MHamiid/Programmable_8-bit_Computer/README.md

# Programmable_8-bit_Computer
Simulated [Ben Eater](https://eater.net/8bit)'s programmable 8-bit computer from scratch using only simple logic gates and basic ICs

## Modules
[Clock](#clock)  
[Bus](#bus)  
[A Register](#a-register)  
[B Register](#b-register)  
[ALU](#alu)  
[Flags Register](#flags-register)  
[Memory Address Register](#memory-address-register)  
[Memory](#memory)  
[Manual Memory Input](#manual-memory-input)  
[Program Counter](#program-counter)  
[Output Display](#output-display)  
[Instruction Register](#instruction-register)  
[Control Unit](#control-unit)  
[Reset](#reset)  
[Serial Monitor](#serial-monitor)  

## Clock
Clock can operate in **two modes**:
- Astable Mode
- Monostable Mode

In __Astable Mode__ clock speed can be changed by adjusting the _potentiometer_

In __Monostable Mode__ single clock pulse can be generated by pressing the _Generate Clock Pulse Button_

### Main Components
- 2 X 555 ( Timer/Oscillator )

### Clock Selector Truth Table
| **Mode Selector Switch** | **Halt Signal** | **Clock Output**  |
|:---:|:---:|:---:|
| Low | Low | Astable Mode |
| High | Low | Monostable Mode |
| X | High | Low |

### Schematic
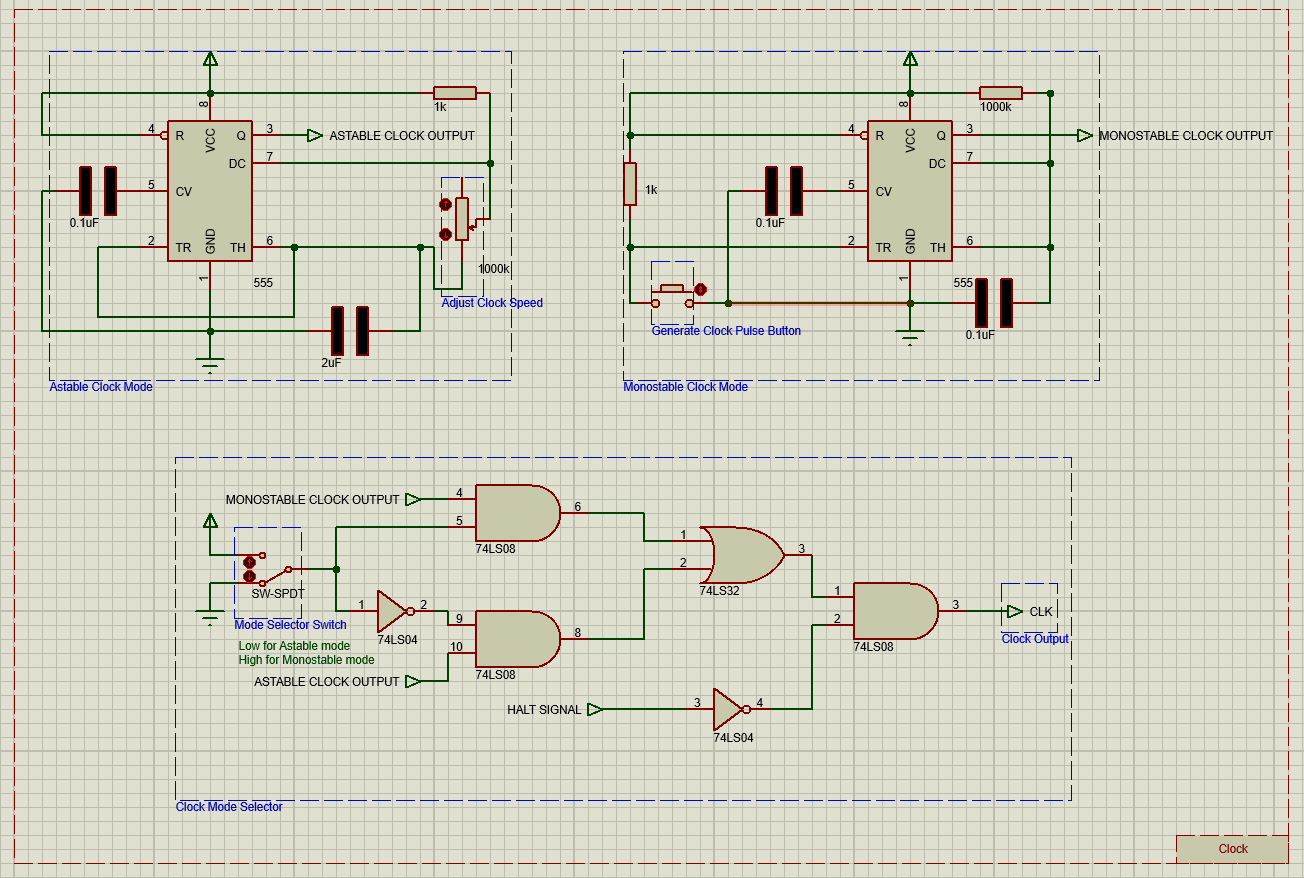
[picture p1: img/Clock_Module.png]
Clock Module


## Bus
All modules are connected to the **Bus** using a **tristate** to connect multiple outputs together

The **Bus** is connected to _pull down resistors_ to pull the **Bus** to _ground_ by default if there is no input

### Schematic
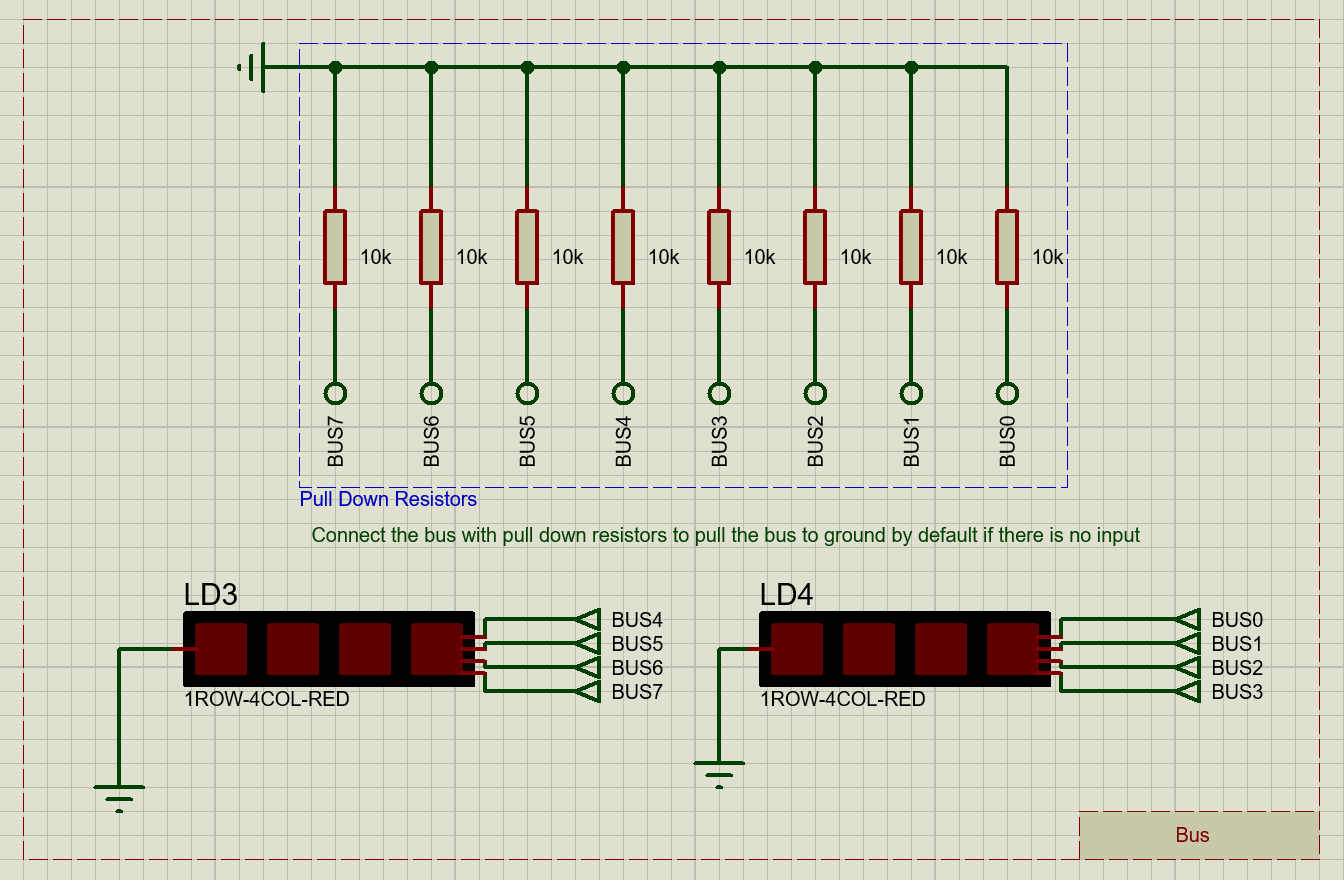
[picture p2: img/Bus_Module.png]
Bus Module


## A-Register
**A-Register** is an _8-bit_ register combined from _two 4-bit_ registers

The **register** is connected to the [Bus](#bus) through a _Tristate_

The **register** also has a direct connection to [ALU](#alu)'s inputs

### Main Components
- 2 X 74LS173 ( Quad D-Type Filp-Flops With Tristate Outputs )
- 74LS245 ( Octal Bus Transceivers With Tristate Outputs )

### A-Register Signals
| **Signal** | **Functionality** |
|:---:|:---:|
|  A Register In Signal | Read the [Bus](#bus) content into **A Register** |
| A Register Out Signal | Output **A Register** content to the [Bus](#bus) |
| Active High Reset | Reset **A Register** content |

### Schematic
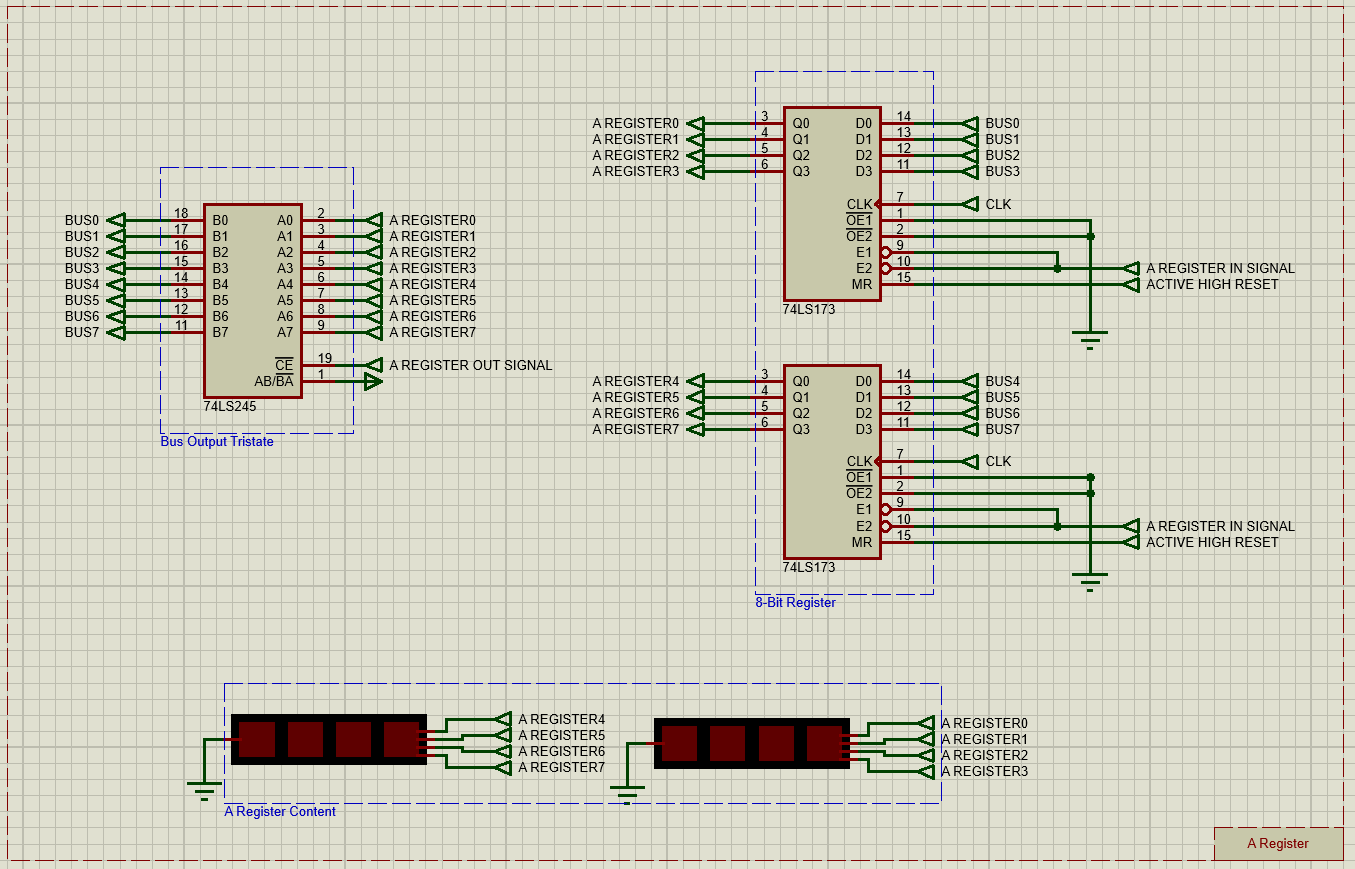
[picture p3: img/A-Register_Module.png]
A-Register Module


## B-Register
**B-Register** is an _8-bit_ register combined from _two 4-bit_ registers

The **register** is connected to the [Bus](#bus) through a _Tristate_

The **register** also has a connection to [ALU](#alu)'s inputs through _XOR Gates_ that decide whether the **register**'s content should be negated or not based on the **Subtraction Signal** for _subtraction_ operations

### Main Components
- 2 X 74LS173 ( Quad D-Type Filp-Flops With Tristate Outputs )
- 74LS245 ( Octal Bus Transceivers With Tristate Outputs )
- 8 X 74LS86 ( 2-Input Exclusive-OR Gate )

### B-Register Signals
| **Signal** | **Functionality** |
|:---:|:---:|
|  B Register In Signal | Read the [Bus](#bus) content into **B Register** |
| B Register Out Signal | Output **B Register** content to the [Bus](#bus) |
| Subtract Signal | Negate **B Register** content ( Get one's complement ) |
| Active High Reset | Reset **B Register** content |

**Note:** The [Control Unit](#control-unit) currently has no **Microinstruction** that controls the **B Register Out Signal**, and the signal is manually fixed to be _inactive (aka HIGH)_ 

### Schematic
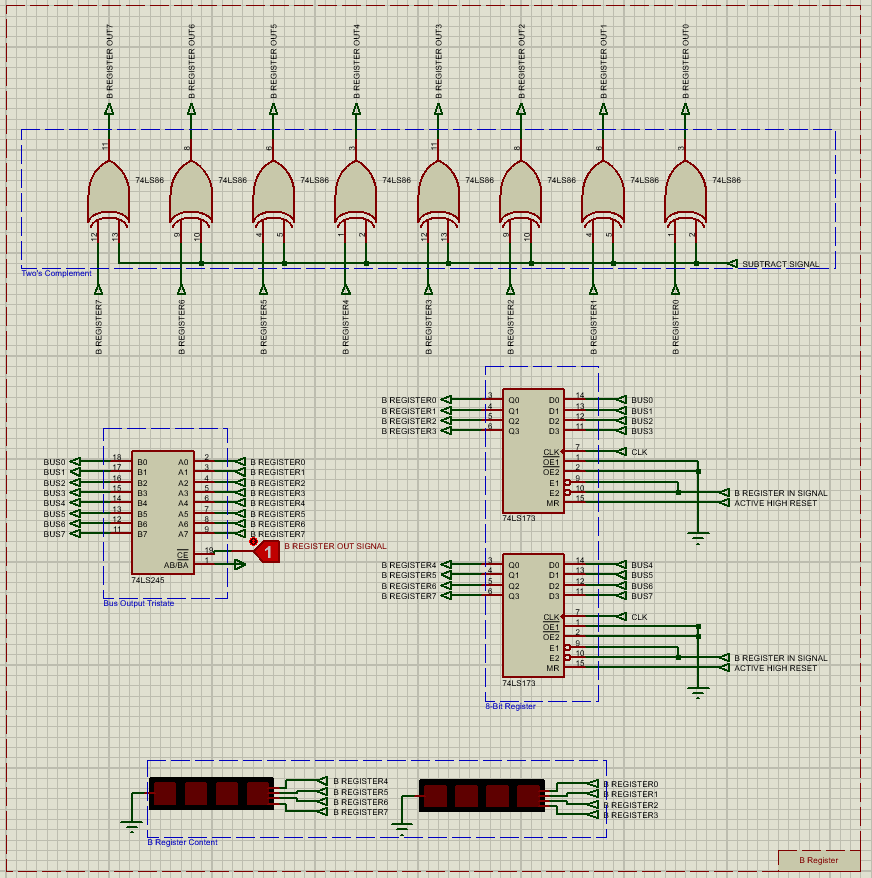
[picture p4: img/B-Register_Module.png]
B-Register Module


## ALU
**ALU** is an _8-bit_ **Full Adder** combined from _two 4-bit_ **Full Adders**

Both [A-Register](#a-register) and [B-Register](#b-register) are connected to the **ALU**'s input, and the **ALU** is _constantly_ operating on them

**ALU** supports two **Arithmetic Operations**:
- Addition
- Subtraction

**Subtraction** is achieved when the **Subtraction Signal** is enabled _(Active **HIGH**)_, resulting in the [B-Register](#b-register)'s content to be negated, hence, getting **One's Complement**. And the **Subtraction Signal** is also fed to the **carry In** of the first **Full Adder** of the **ALU** **_(C0)_** _(Note the **Subtraction Signal** is active **HIGH**)_, hence, getting **Two's Complement**

**ALU** generates two **Flags**:
- Carry Flag
- Zero Flag

### Main Components
- 2 X 74LS283 ( 4-Bit Binary Full Adders With Fast Carry )
- 74LS245 ( Octal Bus Transceivers With Tristate Outputs )
- 74HC4078 ( 8-Input NOR Gate )

### ALU Signals
| **Signal** | **Functionality** |
|:---:|:---:|
|  ALU Out Signal | Output **ALU** content to the [Bus](#bus) |
| Subtract Signal | Fed to the **Carry In** for subtraction operation ( Get two's complement ) |

### Schematic
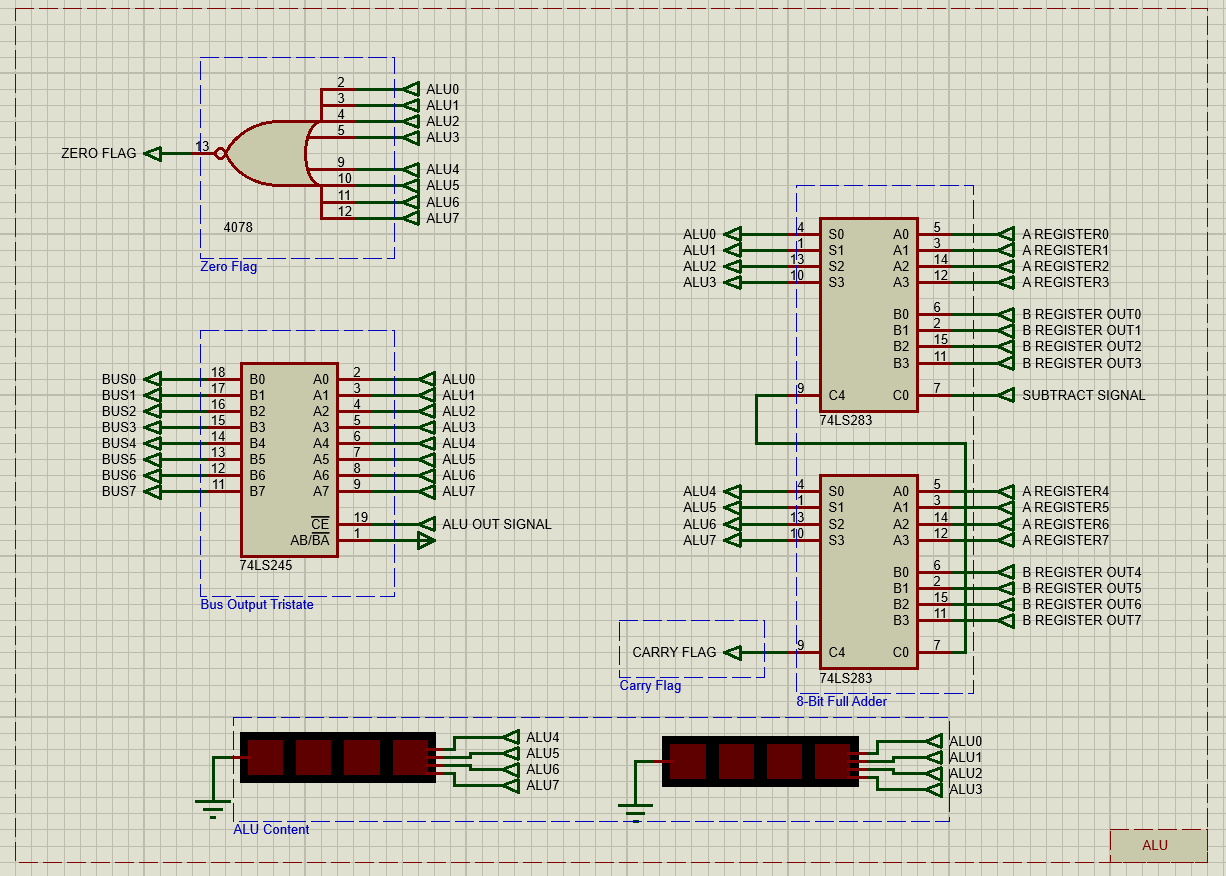
[picture p5: img/ALU_Module.png]
ALU Module


## Flags-Register
**Flags Register** is a 4-bit register, which stores the [ALU](#alu)'s two generated flags:
- Carry Flag
- Zero Flag

when the **Flags Register In Signal** is enabled

The **register**'s output flags are connected to the [Control Unit](#control-unit) to support the **Jump Carry and Jump Zero Instructions** 

### Main Components
- 74LS173 ( Quad D-Type Filp-Flops With Tristate Outputs )

### Flags-Register Signals
| **Signal** | **Functionality** |
|:---:|:---:|
| Flags Register In Signal | Read [ALU](#alu)'s **Flags** into **Flags Register** |
| Active High Reset | Reset **Flags Register** content |

### Schematic
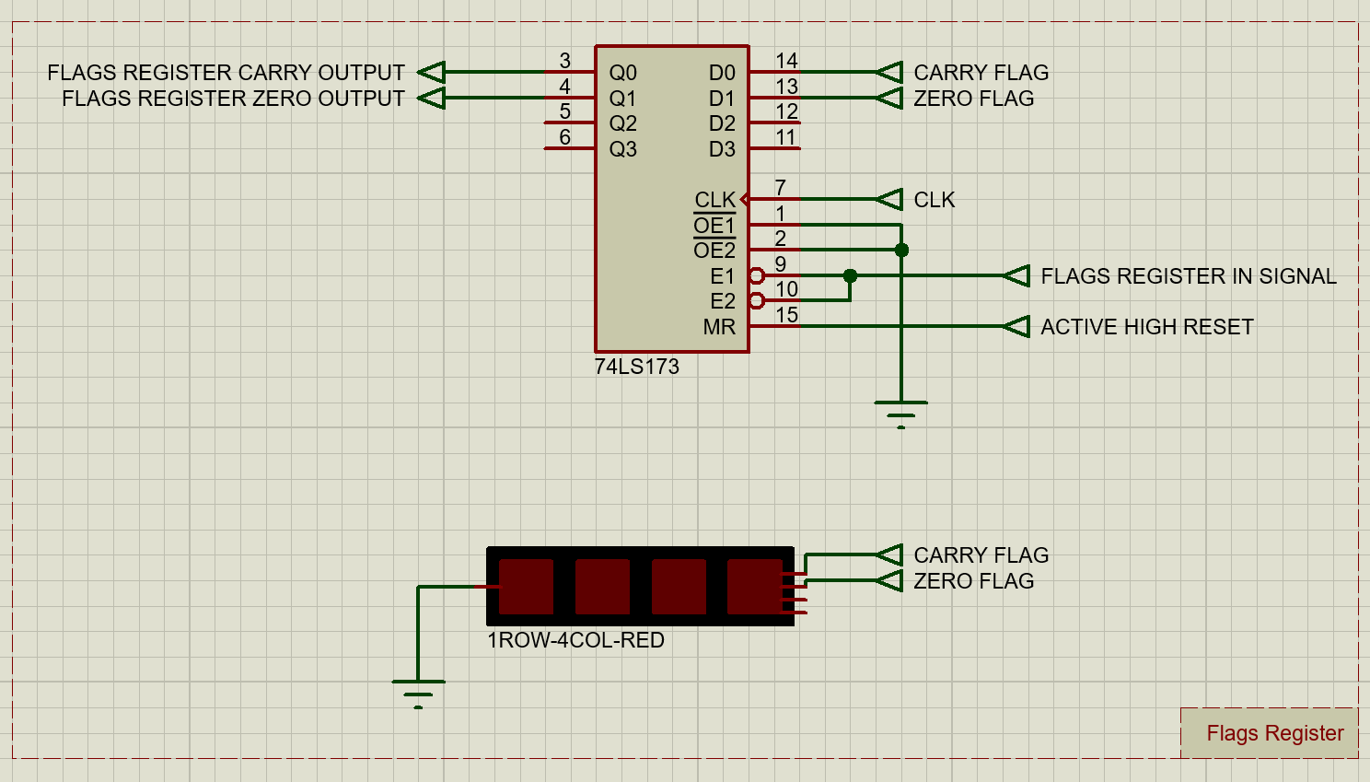
[picture p6: img/Flags-Register_Module.png]
Flags Register Module


## Memory-Address-Register
**Memory Address Register** is a 4-bit register, which stores the 4-bit **memory** address where the **memory** is going to read and output this address content _(If it is **Run Mode**, otherwise in **Programming Mode**, the **memory** is going to use and output the content of the **Manual Address Input**)_

The **register**'s output is connected to the **Memory Address Input Selector** 

### Main Components
- 74LS173 ( Quad D-Type Filp-Flops With Tristate Outputs )

### Memory-Address-Register Signals
| **Signal** | **Functionality** |
|:---:|:---:|
| Memory Address In Signal | Read the [Bus](#bus) content into **Memory Address Register** |
| Active High Reset | Reset **Memory Address Register** content |

### Schematic
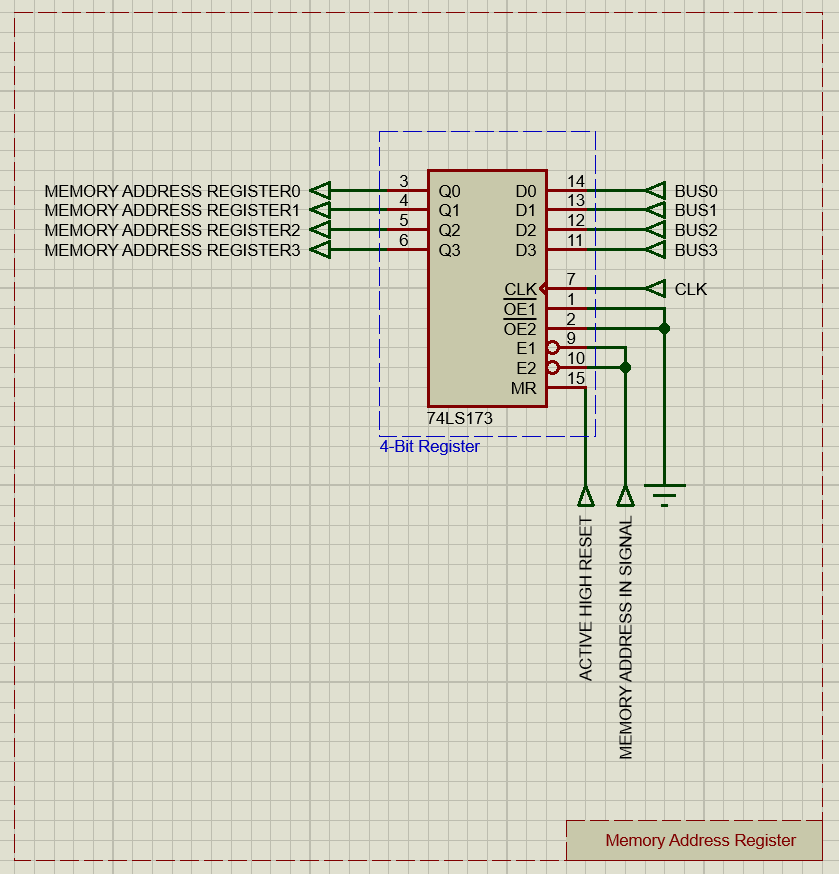
[picture p7: img/Memory-Address-Register_Module.png]
Memory Address Register Module


## Memory
**Memory** is a **128-bit (16 X 8)** memory combined from _two 64-bit (16 X 4)_ **Random Access Read/Write Memory**

The **Memory** is connected to the [Bus](#bus) through a _Tristate_

The inputs **(Memory Data Input, Memory Address, and Memory Write Enable)** to the **Memory** is the outputs of the **Memory Data Input Selector/Multiplexer, Memory Address Input Selector/Multiplexer, and Memory Write Enable Selector/Multiplexer** where the:

- **Memory Data Input Selector/Multiplexer**: Decides whether the _manual memory data input_ or _the data on the [Bus](#bus)_ will be used as an input to the **Memory**

- **Memory Address Input Selector/Multiplexer**: Decides whether the _manual memory address input_ or _the address in the [Memory Address Register](#memory-address-register)_ will be used as an input to the **Memory**

- **Memory Write Enable Selector/Multiplexer**: Decides whether the _manual memory write enable_ or _the **Memory In Signal** with the positive edge of the clock_ will be used as an input to the **Memory**

The **Manual Inputs** referenced above are generated from the [Manual Memory Input Module](#manual-memory-input)

All **Selectors/Mutliplexers** selects the input to the **Memory** based on the **Programming Mode Enable Signal** generated also in the [Manual Memory Input Module](#manual-memory-input)

### Main Components
- 2 X 74LS189 ( 64-Bit Random Access Read/Write Memory )
- 4 X 74LS157 ( Quadruple 1-of-2 Data Selectors/Multiplexers )
- 74LS245 ( Octal Bus Transceivers With Tristate Outputs )

### Memory Signals
| **Signal** | **Functionality** |
|:---:|:---:|
| Memory Out Signal | Output **Memory** content to the [Bus](#bus) |
| Memory In Signal | Generates the **Memory Write Enable Pulse** with the **[Clock](#clock)'s positive edge** |
| Memory Write Enable | Write the **Data** to the **Memory** at the specified **Address** |
| Programming Mode Enable Signal | Selects between the inputs of the two **Selectors/Multiplexers** |

### Schematic
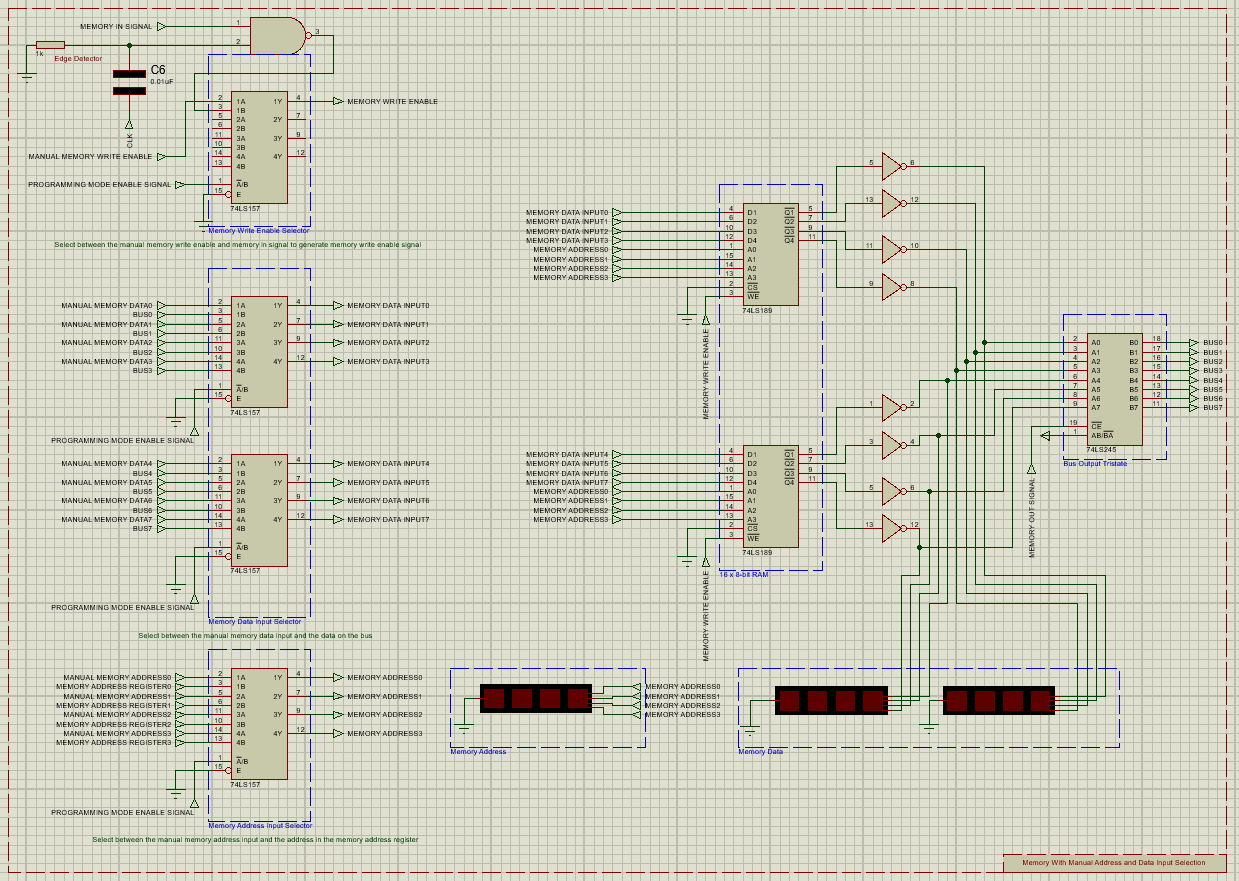
[picture p8: img/Memory_Module.png]
Memory Module


## Manual-Memory-Input
**Manual Memory Input** consists of:
- **Memory Address Manual Input**: Where the **4-bit [Memory](#memory) Address** is entered manually through the _Dip Switches_

- **Memory Data Manual Input**: Where the **8-bit [Memory](#memory) Data** is entered manually through the _Dip Switches_

- **Memory Manual Write Enable Input**: Where the **[Memory](#memory)'s Write Enable Signal** is generated manually by pressing the _Button_

- **Memory Programming/Run Mode Selector**: Generates the **Programming Mode Enable Signal** that selects between the **Programming Mode** where all the [Memory](#memory) inputs are supplied from the [Manual Memory Input Module](#manual-memory-input), and the **Run Mode** where all the [Memory](#memory) inputs are supplied from the corresponding source for each input as stated in the [Memory Module](#memory). _(Note the LEDs that indicate which mode you are operating in based on the state of the **Switch**)_

### Main Components
- DIPSW_4 ( Interactive DIP Switch 4 Independent Elements )
- DIPSW_8 ( Interactive DIP Switch 8 Independent Elements )
- Button ( SPST Push Button )
- Switch ( Interactive SPST Switch (Latched Action) )

### Manual Memory Input Signals
| **Signal** | **Functionality** |
|:---:|:---:|
| Programming Mode Enable Signal | Selects between the **Programming Mode** and **Run Mode** |

### Schematic
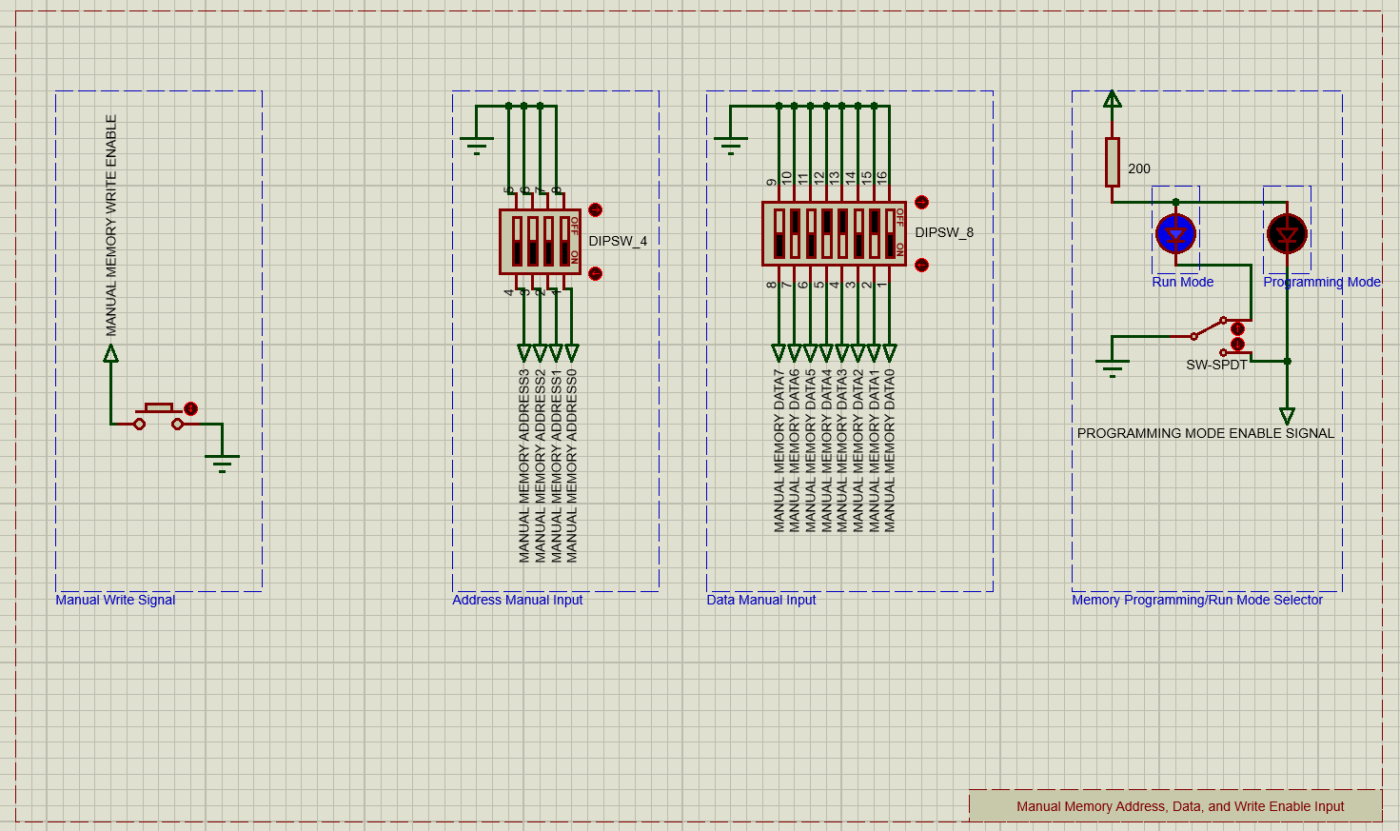
[picture p9: img/Manual-Memory-Input_Module.png]
Manual Memory Input Module


## Program-Counter
**Program Counter** is a _4-bit binary counter_ which gets incremented with each **[Clock](#clock) pulse** if the **Program Counter Enable Signal** is enabled

The **Program Counter** also supports loading a _4-bit_ data from the [Bus](#bus) when the **Program Counter In Signal** is enabled _(Note that, this is used to implement the **Jump Instruction**)_ 

The **Program Counter**'s output is connected to the [Bus](#bus) through a _Tristate_, however, its input is connected to the [Bus](#bus) directly 

### Main Components
- 74LS161 ( Synchronous 4-Bit Binary Counters )
- 74LS245 ( Octal Bus Transceivers With Tristate Outputs )

### Program-Counter Signals
| **Signal** | **Functionality** |
|:---:|:---:|
| Program Counter In Signal | Load the **lowest 4-bits** from the [Bus](#bus) into **Program Counter** |
| Program Counter Out Signal  | Output **Program Counter** content to the [Bus](#bus) |
| Program Counter Enable Signal | Enable **Program Counter** counting which is synchronized with the [Clock](#clock) |
| Active Low Reset | Reset **Program Counter** content |

### Schematic
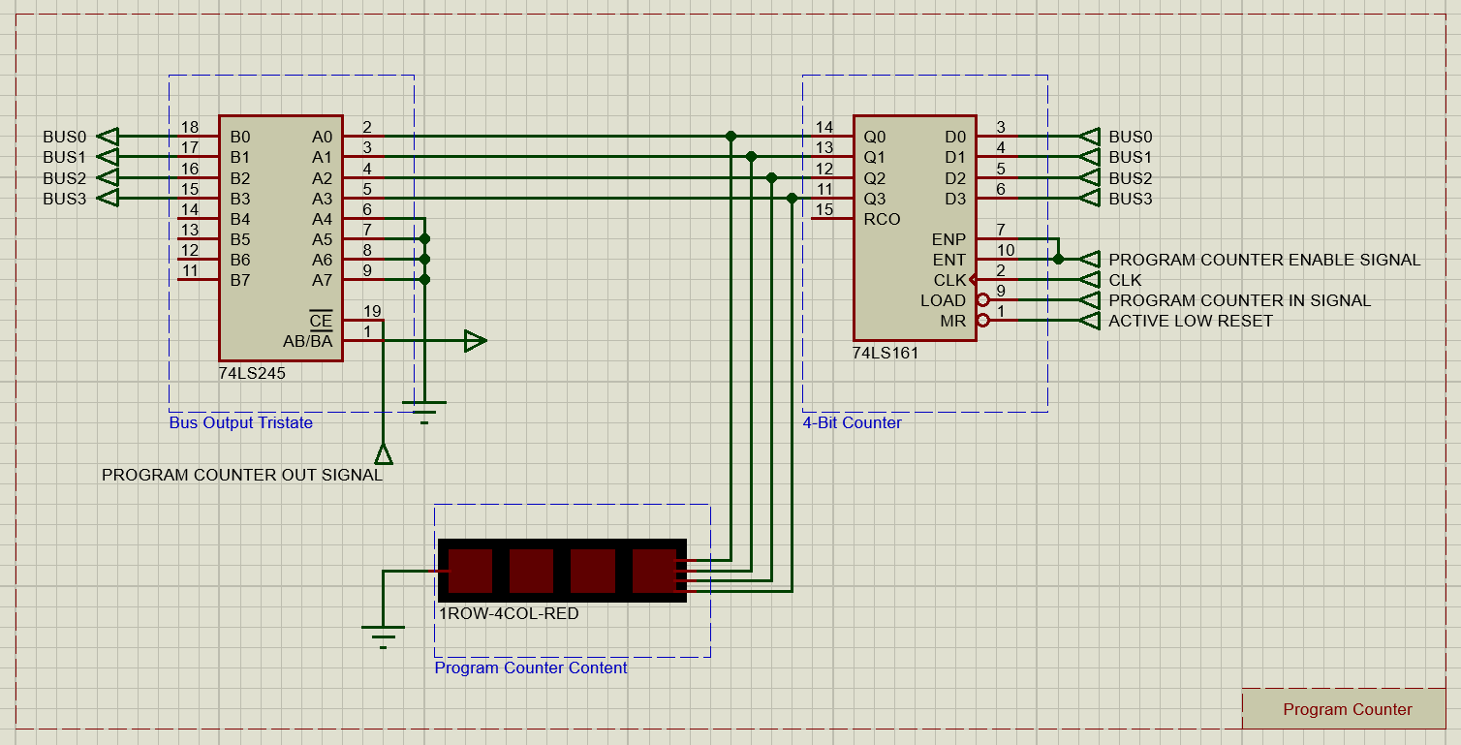
[picture p10: img/Program-Counter_Module.png]
Program-Counter Module


## Output-Display
**Output Display Module** can be divided into sections and sub-modules:

- **Output Display**: _Four 7-Segments_, _three_ of which display **digits** while the _fourth_ display the **sign** ( Sign is supported but currently not utilized )

- **7-Segments Multiplexing Circuit**: Mutliplexes through the **Four 7-Segments** (After the **Arduino** finishes programming the **EEPORM**), using a **2-Bit Counter** (Counting from 0 to 3) and a **2 to 4 Decoder** that takes the **2-Bit Counter** output and outputs the four **Seven Segment Enable Signal**, where they select which **7-Segment** should be active at a time. The **Multiplexing Speed** can be adjusted using the **555 Timer**

- **Output Display Register**: _8-bit_ register which stores in binary the current **Output Display** value being displayed on the **7-Segments**. The **Register**'s _output_ is connected to the **Display EEPORM _address input_** through a _Tristate_ which enables the **Register**'s output to the **Display EEPORM** (After the **Arduino** finishes programming the **EEPORM**). The **Register**'s _input_ is connected directly to the [Bus](#bus)

- **Display EEPROM**: Programmed using the **Arduino** such as, it would take the _binary output display value_ from the **Output Display Register** as an **Address** to the **Display EEPROM**, and it outputs the **7-Segments** representation for each digit. The **EEPORM** has **four** sections for each the **Positive Numbers** and the **Negative Numbers (Two's Complement)**, **three** sections for each digit placement and the **fourth** is for the sign. These sections are:
    - Ones Place
    - Tens Place
    - Hundreds Place
    - Sign Place
    
    As that, the **_8-bit_ Output Display Register** value can be represented by up to _three digits_ and the _sign_ **( 0 to 255 for Positive representation )** and **( -127 to 128 for Negative representation )**
    
    ### Display EEPROM Content
    
    |   **Address**   |                   **7-Segments Digit**                  |
    |:---------------:|:-------------------------------------------------------:|
    |   **0 : 255**   |      **Ones Place** of the numbers **( 0 : 255 )**      |
    |  **256 : 511**  |      **Tens Place** of the numbers **( 0 : 255 )**      |
    |  **512 : 767**  |    **Hundreds Place** of the numbers **( 0 : 255 )**    |
    |  **768 : 1023** | Blank 7-Segments to indicate it is a **Positive Value** |
    | **1024 : 1279** |     **Ones Place** of the numbers **( -128 : 127 )**    |
    | **1280 : 1535** |     **Tens Place** of the numbers **( -128 : 127 )**    |
    | **1536 : 1791** |   **Hundreds Place** of the numbers **( -128 : 127 )**  |
    | **1792 : 2047** |  Output **"-"** to indicate it is a **Negative Value**  |

    From the **table**:

    - By controlling the **EEPROM**'s **Address bit 8** and **Address bit 9**, we can control which digit place and sign place we output for that **8-bit binary number** _(AKA the address of the EEPROM, which is fed from the **8-bit Output Display Register**)_

    - By controlling the **EEPROM**'s **Address bit 10**, we can select if that **8-bit binary number** _(AKA the address of the EEPROM, which is fed from the **8-bit Output Display Register**)_ should be represented as a **Positive Number** or as a **Negative Number (Two's Complement)**

- **Display EEPROM Programmer**: Programs the **Display EEPROM** as discussed. It outputs the **EEPROM Addresses** serially to _shift registers (to make them **parallel** as the number of the **Arduino** pins are limited)_, while it outputs the **EEPORM Data** parallelly. It is also connected to a **Serial Monitor** for outputting the state of the **EEPORM** programming  

### Main Components
- 4 X 7-Segments ( 7-Segments Common Cathode )
- 555 ( Timer/Oscillator )
- 2 X 74LS76 ( Dual JK Flip-Flops With Set And Reset )
- 74LS139 ( Dual 2-Line to 4-Line Decoders/Demultiplexers )
- 74LS273 ( Octal D-Type Positive-Edge-Triggered Flip-Flops With Clear )
- 62256 ( CMOS RAM (32k X 8-bit) )
- Arduino Nano ( ATMEGA328P )
- 2 X 74HC595 ( 8-Bit Shift Registers With Tristate Output Registers )
- 2 X 74LS245 ( Octal Bus Transceivers With Tristate Outputs )

### Ouput-Display Signals
| **Signal** | **Functionality** |
|:---:|:---:|
| Output Register In | Read the [Bus](#bus) content into **Output Display Register** |
| Display EEPROM Output Enable Bit  | Indication that the **Arduino** finished its programming |
| Display EEPROM Write Enable | Write the data to the **Display EEPROM** with the provided address |
| Display EEPROM Address8/9 | Select between the **three Digit Places** and the **Sign Place** |
| Display EEPROM Address10 | Select between the representation of the **Output Display Register** as a **Positive Number** or as a **Negative Number (Two's Complement)** |
| Display Seven Segments Switch Clock | Clock that controls the speed of the **four 7-Segments** multiplexing |
| Active Low Reset | Reset **Output Display Register** content |

### Schematic
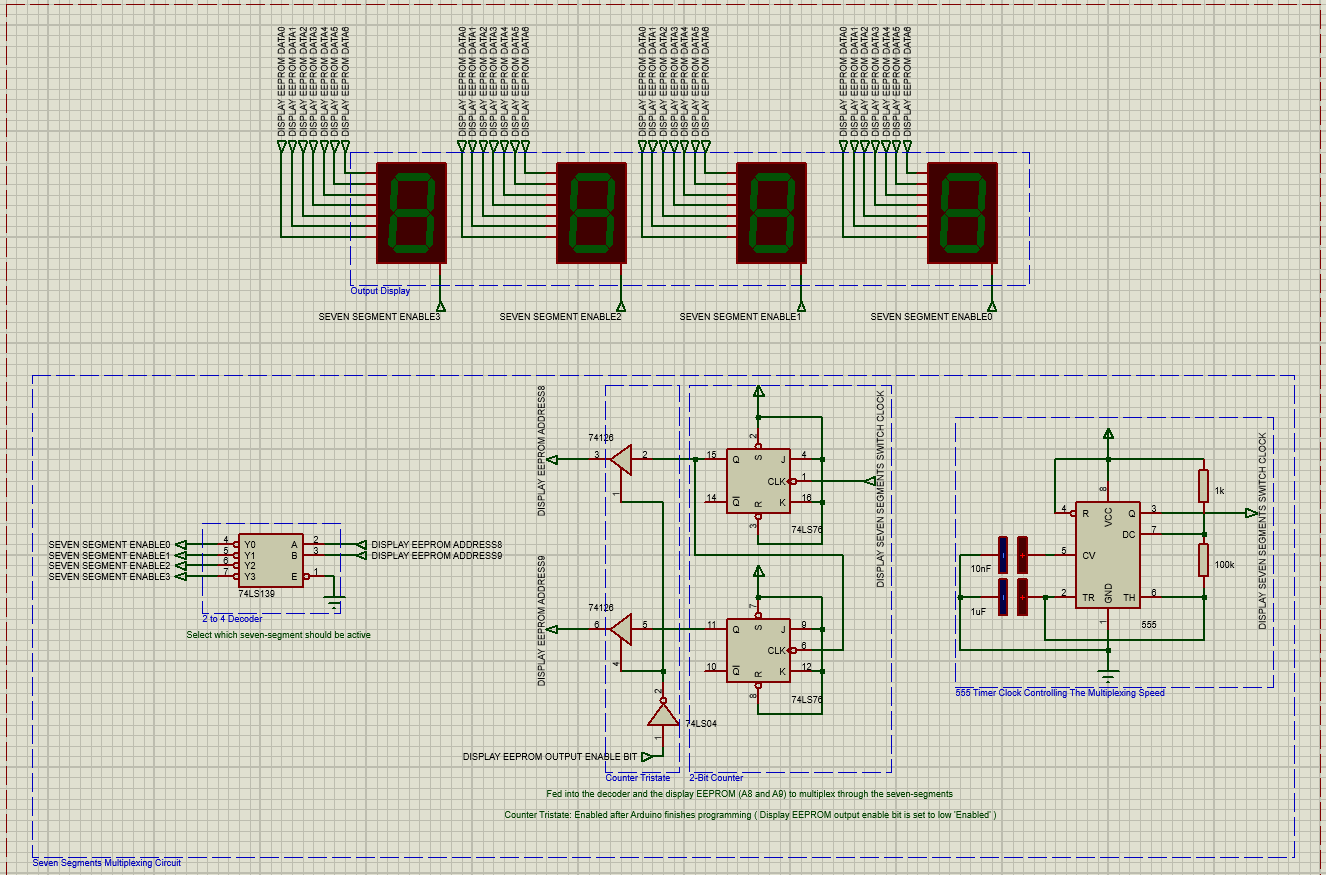
[picture p11: img/Output-Display_Module_1.png]
Output-Dispaly Module_1

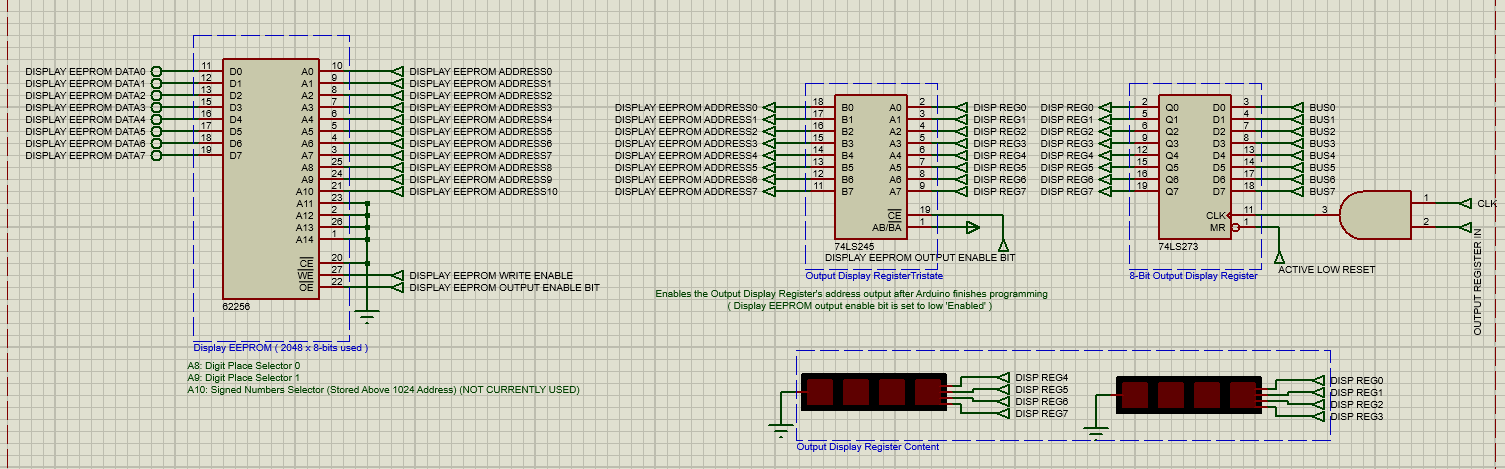
[picture p12: img/Output-Display_Module_2.png]
Output-Dispaly Module_2

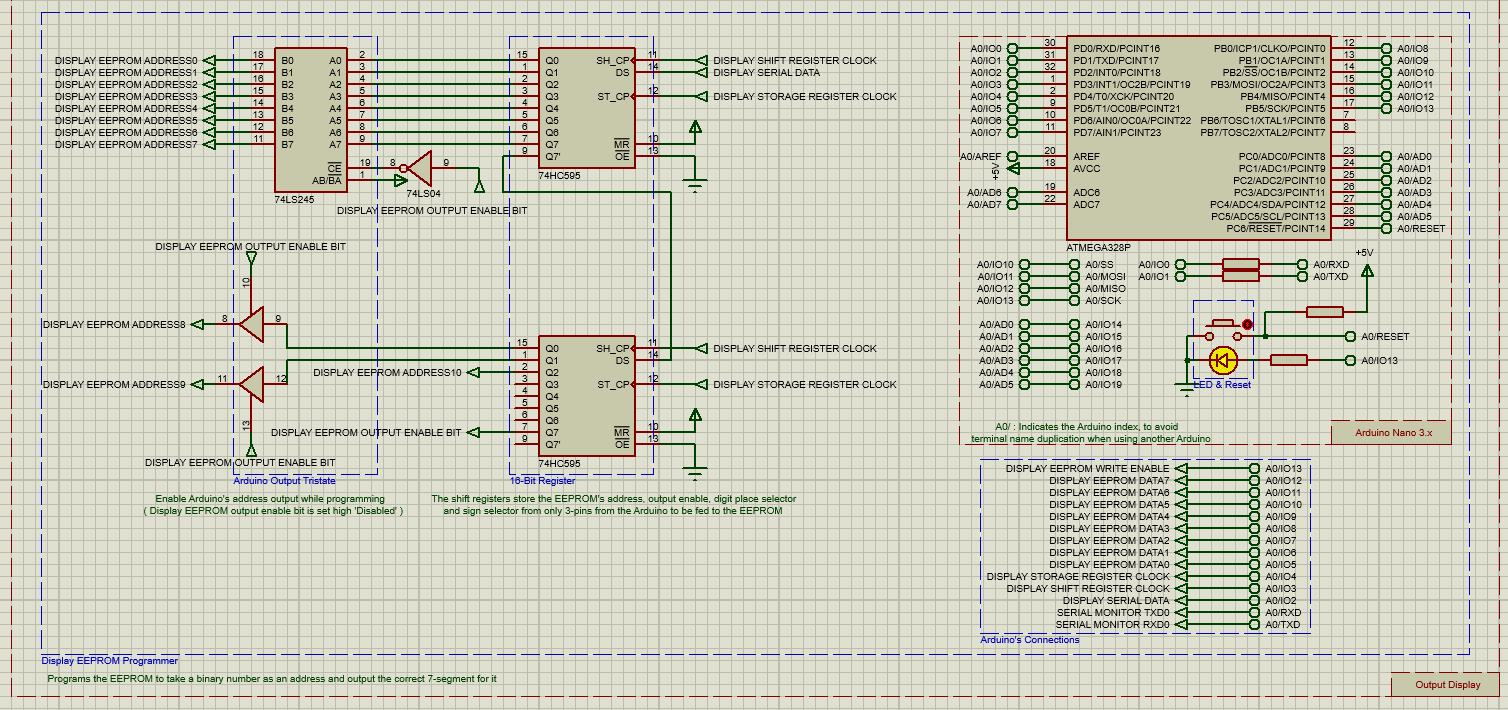
[picture p13: img/Output-Display_Module_3.png]
Output-Dispaly Module_3


## Instruction-Register
**Instruction Register** is an _8-bit_ register combined from _two 4-bit_ registers

Each **_4-bit_** stores a different information where:

- Lower _4-bit_: Contains the **Operand (Data)**

- Higher _4-bit_: Contains the **Operation[OP] Code (Instruction)**

The **Instruction Register**'s input is connected directly to the [Bus](#bus), however, **only** its **Lower _4-bit_ output (the Operand)** is connected to the [Bus](#bus) through a _Tristate_
 
### Main Components
- 2 X 74LS173 ( Quad D-Type Filp-Flops With Tristate Outputs )
- 74LS245 ( Octal Bus Transceivers With Tristate Outputs )

### Instruction-Register Signals
| **Signal** | **Functionality** |
|:---:|:---:|
|  Instruction Register In Signal | Read the [Bus](#bus) content into **Instruction Register** |
| Instruction Register Out Signal | Output **Instruction Register** _lower 4-bit_ **(Operand)** content to the [Bus](#bus) |
| Active High Reset | Reset **Instruction Register** content |

### Schematic
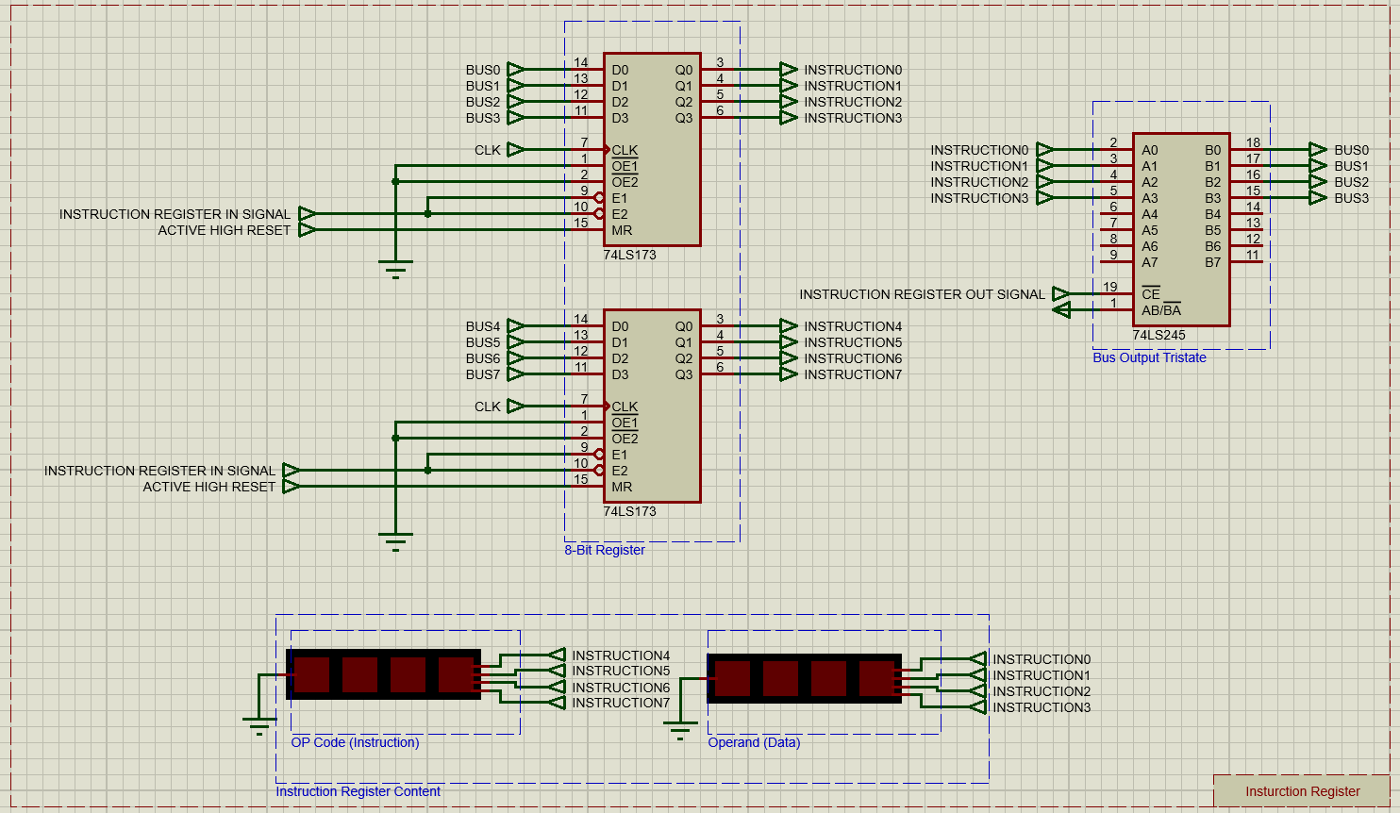
[picture p14: img/Instruction-Register_Module.png]
Instruction-Register Module


## Control-Unit
Outputs the **_16-bit_ Control Word** using **Control Unit EEPROMs** as a _lookup table_

**Control Unit Module** can be divided into sections and sub-modules:

- **Microcode Counter**: 
    - Counts **from 0 to 4 _(Five Steps/Cycles)_**, as the **Microcode Counter Reset Signal** resets the **Mircocode Counter**  instantly to **zero** when it reaches the **fifth** count/tick.

    - As Each **instruction** requires **Five Steps/Cycles** to execute the **Fetch, decode, and excute** cycle
    
    - Counter is incremented with the **inverse** of each clock cycle. As to set the approprite **control signals** before the next rising edge of the clock

    - **Microcode counter _3-bit_ output** is fed to the **Control Unit EEPROMs**'s addresses **0 to 2** (After the **Arduino** finishes programming the **EEPORM**)

- **Control Unit EEPROMs Input Selector**: Selects the **_address input_** for the **Control Unit EEPROMs** between:
    - The **Arduino**'s address output. **(When programming the EEPROM)**

    - The **Mircocode Counter** output with the **Instruction Register** _higher byte output (The Operation[OP] Code (Instruction))_ with the **Flags Register** output. **(After the **Arduino** finishes programming the EEPORM)**

- **Control Unit EEPROMs**: Consists of **two EEPROMS** programmed **_identically_** where the **first EEPROM** is used to output the **higher _8-bit_** of the **Control Word** and the **second EEPROM** is used to output the **lower _8-bit_** of the **Control Word**.

    And selection between the **first EEPROM** output and the **second EEPROM** output **(After being programmed)** can be made using the **_Address Line 7_** of the **EEPROMs** where the **first EERPOM**'s **_Address Line 7_** is fixed to **Low** and the **second EERPOM**'s **_Address Line 7_** is fixed to **High**.

    |  **Control EEPROM Output Enable Bit**  |                   **First EEPROM Address 7**                   |                   **Second EEPROM Address 7**                  |
    |:--------------------------------------:|:--------------------------------------------------------------:|:--------------------------------------------------------------:|
    | **Low (Arduino finished programming)** |                               Low                              |                              High                              |
    |    **High (Arduino is programming)**   | Control EEPROM Address7 (Byte Selector) **(Arduino's Output)** | Control EEPROM Address7 (Byte Selector) **(Arduino's Output)** |

    The **EEPROMs** are programmed using the **Arduino** such as, it would take the:
    - **Microcode Counter _3-bit_** output as the first **3-bit address _0 to 2_** to the **EEPROM**

    - **Instruction Register _higher byte (Operation Code)_** output as **address _3 to 6_** to the **EEPROM**
        
    - **Address 7** is used as a selector between the output intended for each **EEPROM**, as they are programmed **_identically_**. Where the _intended output_ of the **first EEPROM** is stored where **Address 7** is set **Low** and for **second EEPROM** is stored where **Address 7** is set **High** 

    - **Flags Register _2-bit_** output as **address _8 to 9_** to the **EEPROM**

    **Microinstructions/Microcodes** can be formed by combining different **Control Signals** to form a **_16-bit_ Control Word**:

    | **Control Signal** |               **Control Signal Functionality**               | **Control Signal Bit Position In Control Word** |
    |:------------------:|:------------------------------------------------------------:|:-----------------------------------------------:|
    |       **HLT**      |                   Halt the [Clock](#clock)                   |               **1000000000000000**              |
    |       **MI**       |    [Memory Address Register](#memory-address-register) In    |               **0100000000000000**              |
    |       **RI**       |                     [Memory](#memory) In                     |               **0010000000000000**              |
    |       **RO**       |                     [Memory](#memory) Out                    |               **0001000000000000**              |
    |       **IO**       |       [Instruction Register](#instruction-register) Out      |               **0000100000000000**              |
    |       **II**       |       [Instruction Register](#instruction-register) In       |               **0000010000000000**              |
    |       **AI**       |                 [A Register](#a-register) In                 |               **0000001000000000**              |
    |       **AO**       |                 [A Register](#a-register) Out                |               **0000000100000000**              |
    |       **EO**       |                   [ALU](#alu) Register Out                   |               **0000000010000000**              |
    |       **SU**       | [B Register](#b-register) Subtract Signal Enabled (Subtract) |               **0000000001000000**              |
    |       **BI**       |                 [B Register](#b-register) In                 |               **0000000000100000**              |
    |       **OI**       |         [Output Display](#output-display) Register In        |               **0000000000010000**              |
    |       **CE**       |      [Program Counter](#program-counter) Enable (Count)      |               **0000000000001000**              |
    |       **CO**       |            [Program Counter](#program-counter) Out           |               **0000000000000100**              |
    |        **J**       |         [Program Counter](#program-counter) In (Jump)        |               **0000000000000010**              |
    |       **FI**       |             [Flags Register](#flags-register) In             |               **0000000000000001**              |

    **Control Unit** supports **_11_ Instructions (OP Code)**:
    | **Instruction (OP Code)** |           **Op Code Binary**           |                                                                                                                                                **Functionality**                                                                                                                                                |
    |:-------------------------:|:--------------------------------------:|:---------------------------------------------------------------------------------------------------------------------------------------------------------------------------------------------------------------------------------------------------------------------------------------------------------------:|
    |   **NOP (NO OPERATION)**  | **0000, 1001, 1010, 1011, 1100, 1101** |                                                                                                                                  Doing just the **Fetch** and **Decode** cycle                                                                                                                                  |
    |      **LDA (LOAD A)**     |                **0001**                |                                                                                                           Load data from [Memory](#memory) at the specified address into the [A register](#a-register)                                                                                                          |
    |          **ADD**          |                **0010**                |            Load data from [Memory](#memory) at the specified address into the [B register](#b-register), and load the sum into the [A register](#a-register). And load the flags status into the [Flags Register](#flags-register) before the [Output Display](#output-display)'s register is changed           |
    |     **SUB (SUBRACT)**     |                **0011**                | Load data from [Memory](#memory) at the specified address into the [B register](#b-register), set the subtract bit and load the sum into the [A register](#a-register). And load the flags status into the [Flags Register](#flags-register) before the [Output Display](#output-display)'s register is changed |
    |     **STA (STORA A)**     |                **0100**                |                                                                                                         Load data from the [A register](#a-register) into the [Memory](#memory) at the specified address                                                                                                        |
    |  **LDI (LOAD IMMEDIATE)** |                **0101**                |                                                                                                                        Load the **Operand _(4-bits)_** into the [A register](#a-register)                                                                                                                       |
    |       **JMP (JUMP)**      |                **0110**                |                                                                                 Load the **Operand _(4-bits address we want to jump to)_** into the [Program Counter](#program-counter) to be executed the **next clock cycle**                                                                                 |
    |    **JC (JUMP CARRY)**    |                **0111**                |                                                               If the **Carry Flag** is **_set_**. Load the **Operand _(4-bits address we want to jump to)_** into the [Program Counter](#program-counter) to be executed the **next clock cycle**                                                               |
    |     **JZ (JUMP ZERO)**    |                **1000**                |                                                                If the **Zero Flag** is **_set_**. Load the **Operand _(4-bits address we want to jump to)_** into the [Program Counter](#program-counter) to be executed the **next clock cycle**                                                               |
    |          **OUT**          |                **1110**                |                                                                                                           load data from [A register](#a-register) to the [Output Display](#output-display)'s register                                                                                                          |
    |       **HLT (HALT)**      |                **1111**                |                                                                                                                                      Halt/Stop the computer [Clock](#clock)                                                                                                                                     |

    ### Control Unit EEPROMs Content:
    | EEPROM Address 0 : 2<br><br>Microcode Counter (Step) | EEPROM Address 3 : 6<br><br>Instruction (OP Code) | EEPROM Address 8<br><br>Carry Flag (CF) | EEPROM Address 9<br><br>Zero Flag (ZF) |       Control Word       |
    |:----------------------------------------------------:|:-------------------------------------------------:|:---------------------------------------:|:--------------------------------------:|:------------------------:|
    |                    **000 (Fetch)**                   |                    **X X X X**                    |                  **X**                  |                  **X**                 |       **MI \| CO**       |
    |              **001 (Fetch and Decode)**              |                    **X X X X**                    |                  **X**                  |                  **X**                 |    **RO \| II \| CE**    |
    |                   **010 (Execute)**                  |                   **0000 (NOP)**                  |                  **X**                  |                  **X**                 |   **0000000000000000**   |
    |                   **011 (Execute)**                  |                   **0000 (NOP)**                  |                  **X**                  |                  **X**                 |   **0000000000000000**   |
    |                   **100 (Execute)**                  |                   **0000 (NOP)**                  |                  **X**                  |                  **X**                 |   **0000000000000000**   |
    |                   **010 (Execute)**                  |                   **0001 (LDA)**                  |                  **X**                  |                  **X**                 |       **IO \| MI**       |
    |                   **011 (Execute)**                  |                   **0001 (LDA)**                  |                  **X**                  |                  **X**                 |       **RO \| AI**       |
    |                   **100 (Execute)**                  |                   **0001 (LDA)**                  |                  **X**                  |                  **X**                 |   **0000000000000000**   |
    |                   **010 (Execute)**                  |                   **0010 (ADD)**                  |                  **X**                  |                  **X**                 |       **IO \| MI**       |
    |                   **011 (Execute)**                  |                   **0010 (ADD)**                  |                  **X**                  |                  **X**                 |       **RO \| BI**       |
    |                   **100 (Execute)**                  |                   **0010 (ADD)**                  |                  **X**                  |                  **X**                 |    **EO \| AI \| FI**    |
    |                   **010 (Execute)**                  |                   **0011 (SUB)**                  |                  **X**                  |                  **X**                 |       **IO \| MI**       |
    |                   **011 (Execute)**                  |                   **0011 (SUB)**                  |                  **X**                  |                  **X**                 |       **RO \| BI**       |
    |                   **100 (Execute)**                  |                   **0011 (SUB)**                  |                  **X**                  |                  **X**                 | **EO \| AI \| SU \| FI** |
    |                   **010 (Execute)**                  |                   **0100 (STA)**                  |                  **X**                  |                  **X**                 |       **IO \| MI**       |
    |                   **011 (Execute)**                  |                   **0100 (STA)**                  |                  **X**                  |                  **X**                 |       **AO \| RI**       |
    |                   **100 (Execute)**                  |                   **0100 (STA)**                  |                  **X**                  |                  **X**                 |   **0000000000000000**   |
    |                   **010 (Execute)**                  |                   **0101 (LDI)**                  |                  **X**                  |                  **X**                 |       **IO \| AI**       |
    |                   **011 (Execute)**                  |                   **0101 (LDI)**                  |                  **X**                  |                  **X**                 |   **0000000000000000**   |
    |                   **100 (Execute)**                  |                   **0101 (LDI)**                  |                  **X**                  |                  **X**                 |   **0000000000000000**   |
    |                   **010 (Execute)**                  |                   **0110 (JMP)**                  |                  **X**                  |                  **X**                 |        **IO \| J**       |
    |                   **011 (Execute)**                  |                   **0110 (JMP)**                  |                  **X**                  |                  **X**                 |   **0000000000000000**   |
    |                   **100 (Execute)**                  |                   **0110 (JMP)**                  |                  **X**                  |                  **X**                 |   **0000000000000000**   |
    |                   **010 (Execute)**                  |                   **0111 (JC)**                   |                  **0**                  |                  **X**                 |   **0000000000000000**   |
    |                   **010 (Execute)**                  |                   **0111 (JC)**                   |                  **1**                  |                  **X**                 |        **IO \| J**       |
    |                   **011 (Execute)**                  |                   **0111 (JC)**                   |                  **X**                  |                  **X**                 |   **0000000000000000**   |
    |                   **100 (Execute)**                  |                   **0111 (JC)**                   |                  **X**                  |                  **X**                 |   **0000000000000000**   |
    |                   **010 (Execute)**                  |                   **1000 (JZ)**                   |                  **X**                  |                  **0**                 |   **0000000000000000**   |
    |                   **010 (Execute)**                  |                   **1000 (JZ)**                   |                  **X**                  |                  **1**                 |        **IO \| J**       |
    |                   **011 (Execute)**                  |                   **1000 (JZ)**                   |                  **X**                  |                  **X**                 |   **0000000000000000**   |
    |                   **100 (Execute)**                  |                   **1000 (JZ)**                   |                  **X**                  |                  **X**                 |   **0000000000000000**   |
    |                   **010 (Execute)**                  |                   **1001 (NOP)**                  |                  **X**                  |                  **X**                 |   **0000000000000000**   |
    |                   **011 (Execute)**                  |                   **1001 (NOP)**                  |                  **X**                  |                  **X**                 |   **0000000000000000**   |
    |                   **100 (Execute)**                  |                   **1001 (NOP)**                  |                  **X**                  |                  **X**                 |   **0000000000000000**   |
    |                   **010 (Execute)**                  |                   **1010 (NOP)**                  |                  **X**                  |                  **X**                 |   **0000000000000000**   |
    |                   **011 (Execute)**                  |                   **1010 (NOP)**                  |                  **X**                  |                  **X**                 |   **0000000000000000**   |
    |                   **100 (Execute)**                  |                   **1010 (NOP)**                  |                  **X**                  |                  **X**                 |   **0000000000000000**   |
    |                   **010 (Execute)**                  |                   **1011 (NOP)**                  |                  **X**                  |                  **X**                 |   **0000000000000000**   |
    |                   **011 (Execute)**                  |                   **1011 (NOP)**                  |                  **X**                  |                  **X**                 |   **0000000000000000**   |
    |                   **100 (Execute)**                  |                   **1011 (NOP)**                  |                  **X**                  |                  **X**                 |   **0000000000000000**   |
    |                   **010 (Execute)**                  |                   **1100 (NOP)**                  |                  **X**                  |                  **X**                 |   **0000000000000000**   |
    |                   **011 (Execute)**                  |                   **1100 (NOP)**                  |                  **X**                  |                  **X**                 |   **0000000000000000**   |
    |                   **100 (Execute)**                  |                   **1100 (NOP)**                  |                  **X**                  |                  **X**                 |   **0000000000000000**   |
    |                   **010 (Execute)**                  |                   **1101 (NOP)**                  |                  **X**                  |                  **X**                 |   **0000000000000000**   |
    |                   **011 (Execute)**                  |                   **1101 (NOP)**                  |                  **X**                  |                  **X**                 |   **0000000000000000**   |
    |                   **100 (Execute)**                  |                   **1101 (NOP)**                  |                  **X**                  |                  **X**                 |   **0000000000000000**   |
    |                   **010 (Execute)**                  |                   **1110 (OUT)**                  |                  **X**                  |                  **X**                 |       **AO \| OI**       |
    |                   **011 (Execute)**                  |                   **1110 (OUT)**                  |                  **X**                  |                  **X**                 |   **0000000000000000**   |
    |                   **100 (Execute)**                  |                   **1110 (OUT)**                  |                  **X**                  |                  **X**                 |   **0000000000000000**   |
    |                   **010 (Execute)**                  |                   **1111 (HLT)**                  |                  **X**                  |                  **X**                 |          **HLT**         |
    |                   **011 (Execute)**                  |                   **1111 (HLT)**                  |                  **X**                  |                  **X**                 |   **0000000000000000**   |
    |                   **100 (Execute)**                  |                   **1111 (HLT)**                  |                  **X**                  |                  **X**                 |   **0000000000000000**   |
    |                        **101**                       |                    **X X X X**                    |                  **X**                  |                  **X**                 |   **0000000000000000**   |
    |                        **110**                       |                    **X X X X**                    |                  **X**                  |                  **X**                 |   **0000000000000000**   |
    |                        **111**                       |                    **X X X X**                    |                  **X**                  |                  **X**                 |   **0000000000000000**   |

    **_Note that EEPROM Address 7 is not mentioned in the table. As discussed earlier EEPROM Address 7 is used for selecting the Control Word Byte for each of the two EEPROMS_**

- **Control Unit EEPROMs Programmer**: Programs the **Control Unit EEPROMs** as discussed. It outputs the **EEPROMs Addresses** serially to _shift registers (to make them **parallel** as the number of the **Arduino** pins are limited)_, while it outputs the **EEPORMs Data** parallelly. It is also connected to a **Serial Monitor** for outputting the state of the **EEPORMs** programming  

### Main Components
- 74LS161 ( Synchronous 4-Bit Binary Counters )
- 74LS138 ( 3-Line to 8-Line Decoders/Demultiplexers )
- 3 X 74LS157 ( Quadruple 1-of-2 Data Selectors/Multiplexers )
- 2 X 62256 ( CMOS RAM (32k X 8-bit) )
- Arduino Nano ( ATMEGA328P )
- 2 X 74HC595 ( 8-Bit Shift Registers With Tristate Output Registers )
- 3 X 74LS245 ( Octal Bus Transceivers With Tristate Outputs )

### Control-Unit Signals
| **Signal** | **Functionality** |
|:---:|:---:|
| Microcode Counter Reset Signal | Reset **Microcode Counter** to **0** |
| Control EEPROM Output Enable Bit | Indication that the **Arduino** finished its programming |
| (Inverse) Control EEPROM Output Enable Bit | The inverse of the **Control EEPROM Output Enable Bit** |
| Control EEPROM Write Enable | Write the data to the **Control Unit EEPROMs** with the provided address |
| Control EEPROM Address7 (Byte Selector)  | Select between the **lower** and **higher byte** of the **_16-bit_ Control Word** |
| Active Low Reset | Reset **Microcode Counter** to **0** |

### Schematic
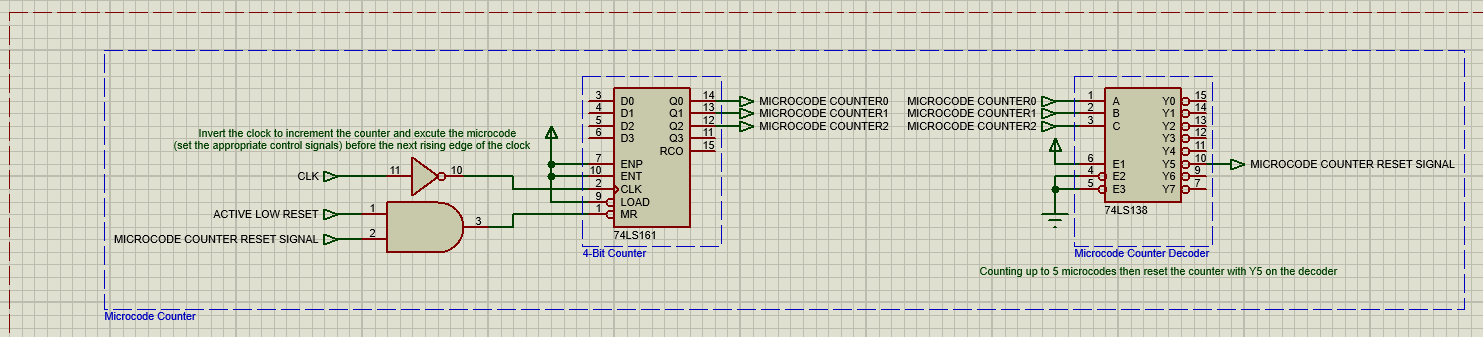
[picture p15: img/Control-Unit_Module_1.png]
Control-Unit Module_1

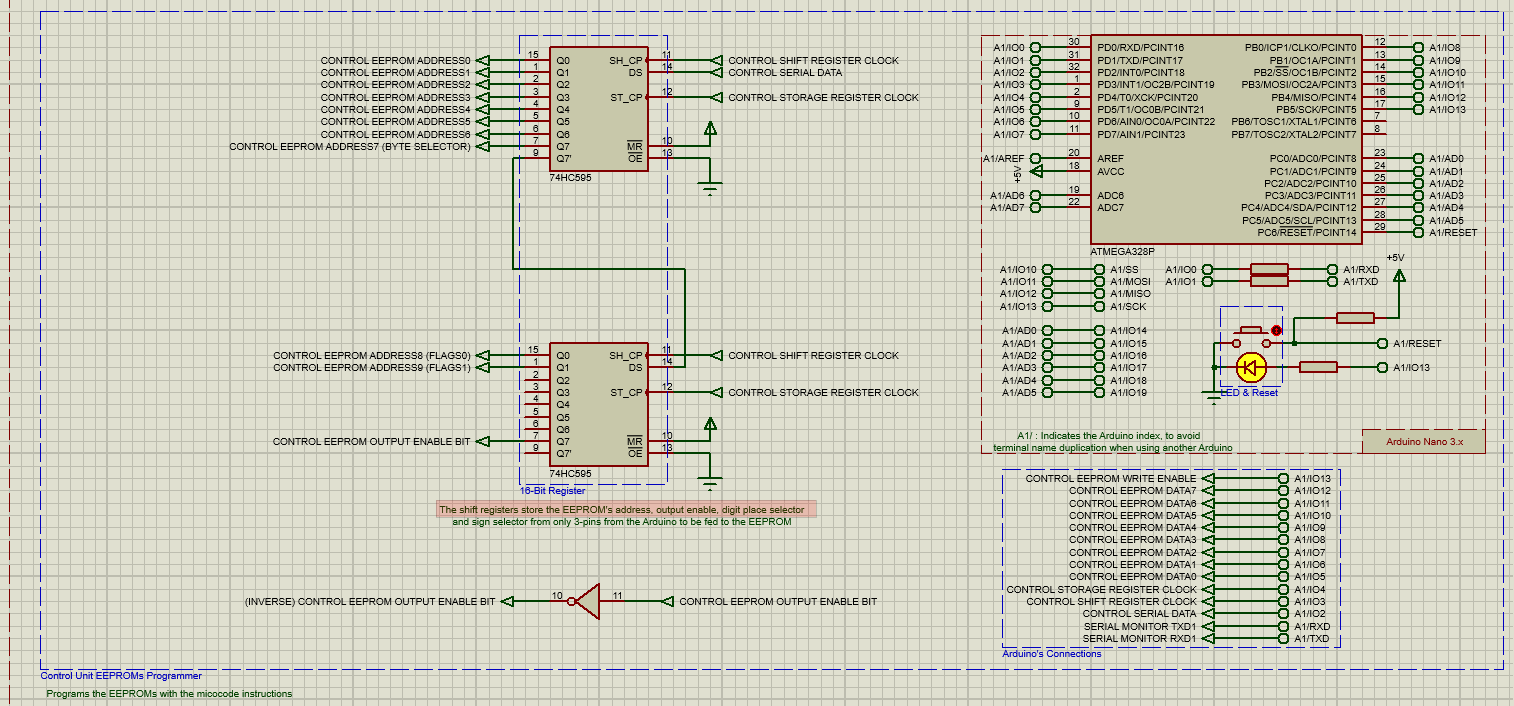
[picture p16: img/Control-Unit_Module_2.png]
Control-Unit Module_2

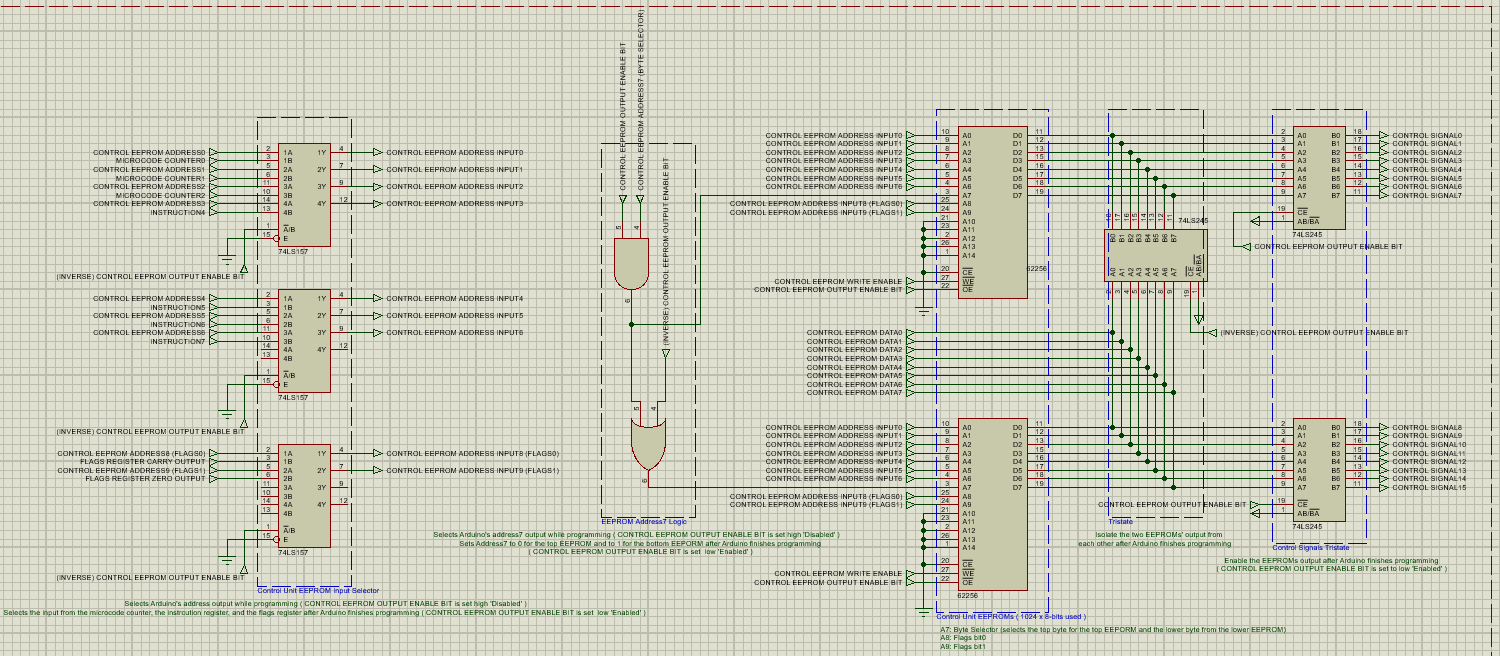
[picture p17: img/Control-Unit_Module_3.png]
Control-Unit Module_3

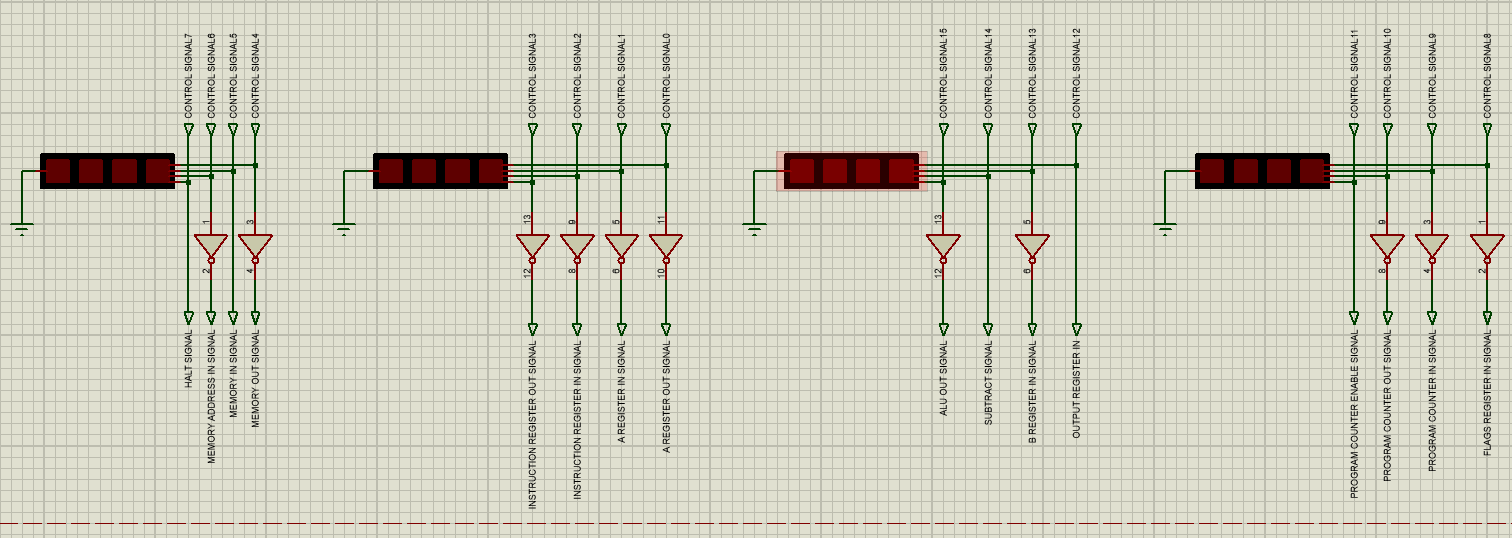
[picture p18: img/Control-Unit_Module_4.png]
Control-Unit Module_4


## Reset
**Reset** generates _two reset signals_ when the **Button** is pressed:

- **Active High Reset**
- **Active Low Reset**

that are used to reset the different computer's modules

### Main Components
- Button ( SPST Push Button )

### Reset Signals
| **Signal** | **Functionality** |
|:---:|:---:|
| Active High Reset | Reset components that reset with an **Active High Signal** |
|  Active Low Reset |  Reset components that reset with an **Active Low Signal** |

### Schematic
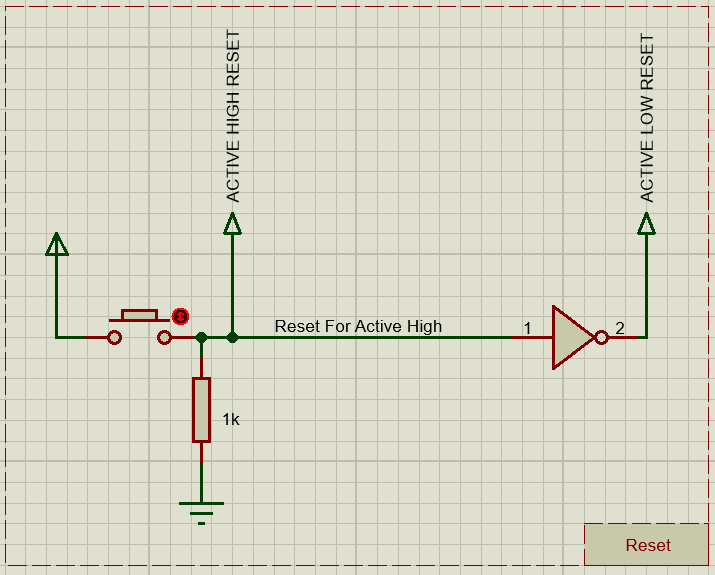
[picture p19: img/Reset_Module.png]
Reset Module


## Serial-Monitor
**Serial Monitor** displays the serial output of the **Arduino** of each module:

- [Output Display](#output-display)
- [Control Unit](#control-unit)

### Main Components
- 2 X Virtual Terminal

### Schematic
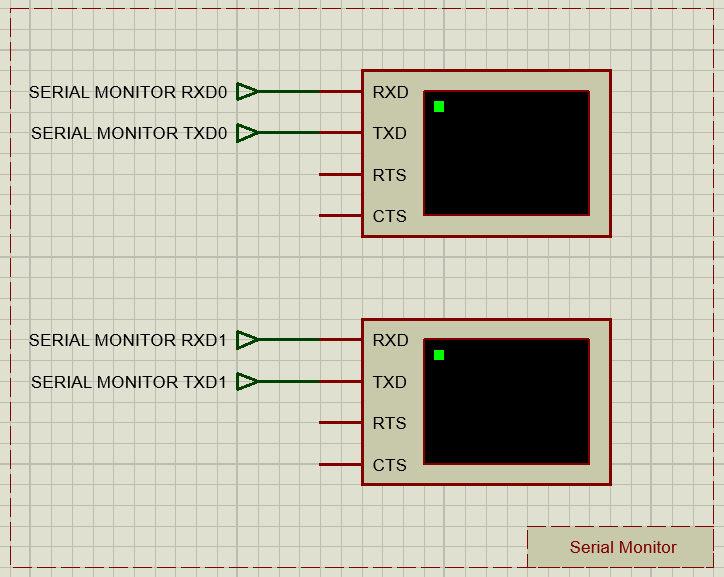
[picture p20: img/Serial-Monitor_Module.png]
Serial-Monitor Module
