MHamiid/Programmable_8-bit_Computer/(list of files, drawings)

Other design files:
proteus/Programmable_8-bit_Computer.pdsprj
