MHamiid/Programmable_8-bit_Computer/(commit log)

2022-08-26 Add project and source code files
    [Programmable_8-bit_Computer.pdsprj]
2022-08-28 Implement using EEPROM_Programmer library Add EEPROM_Programmer source code files in Proteus build
    [Programmable_8-bit_Computer.pdsprj]
2022-09-03 Update clock module circuit description in Proteus
    [Programmable_8-bit_Computer.pdsprj]
2022-09-12 Update memory and manual memory input modules in Proteus Move the memory write enable selector from manual memory input module to memory module
    [Programmable_8-bit_Computer.pdsprj]
2022-09-13 Update README.md memory module due to schematic change Update the new memory module schematic image from Proteus project
2022-09-23 Update comments and schematic description for the control unit module in Proteus Also hide unnecessary component part names for the red LEDs in various modules
    [Programmable_8-bit_Computer.pdsprj]
